jtroyer76/n2k_atom_can485_hw/fab/n2k_atom_can485-bom-jlcpcb.csv

Comment | Designator | Footprint | LCSC Part #
4.7u/50V | C1 | C_1206_3216Metric | C29823
100n/50V | C2,C3,C5,C6,C8,C11 | C_0603_1608Metric | C14663
22u/25V | C4 | C_0805_2012Metric | C45783
10u/25V | C7,C10 | C_0805_2012Metric | C15850
1u/50V | C9,C12 | C_0603_1608Metric | C15849
SMBJ20A | D1 | D_SMB | C19077575
SS14 | D2 | D_SMA | C2480
B5819W | D3 | D_SOD-123 | C8598
PESD2CAN | D4 | SOT-23 | C75176
0.5A/60V PTC | F1 | Fuse_1812_4532Metric | C883142
15u | L1 | L_Sunlord_SWPA5040S | C44888
120k 1% | R1 | R_0603_1608Metric | C25808
22k 1% | R2 | R_0603_1608Metric | C31850
120 1% | R3,R5 | R_0603_1608Metric | C22787
10k 1% | R4 | R_0603_1608Metric | C25804
LMR54406DBVR | U1 | SOT-23-6 | C5219316
TJA1051T/3 | U2 | SOIC-8_3.9x4.9mm_P1.27mm | C38695
CA-IS2092VW | U3 | SOIC-16W_7.5x10.3mm_P1.27mm | C7422559
