jtroyer76/n2k_atom_can485_hw/enclosure/n2k_atom_can485_case-lid.stl

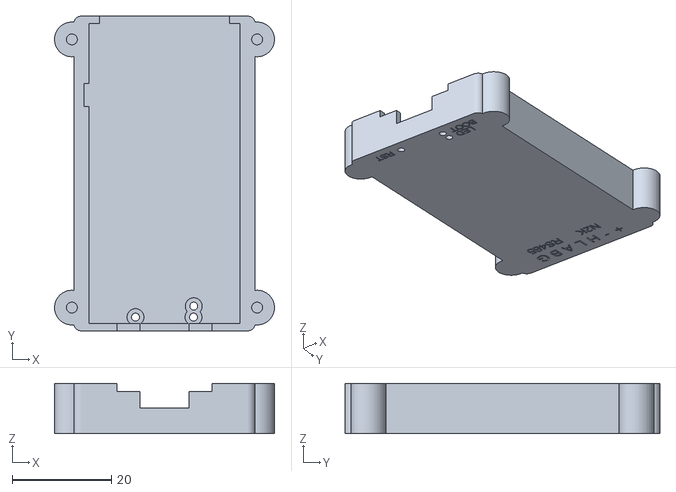
[picture p4: CAD file, 2026-11-02]
enclosure/n2k_atom_can485_case-lid.stl
44.3 x 63.4 x 10.1
