jtroyer76/n2k_atom_can485_hw/enclosure/n2k_atom_can485_case-base.stl

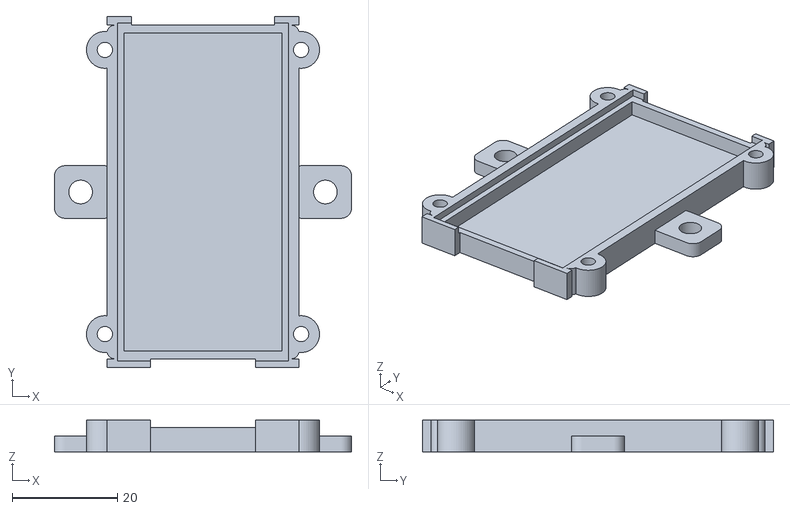
[picture p5: CAD file, 2026-11-02]
enclosure/n2k_atom_can485_case-base.stl
56.5 x 66.7 x 6.00
