jtroyer76/n2k_atom_can485_hw/docs/n2k_atom_can485-schematic.pdf

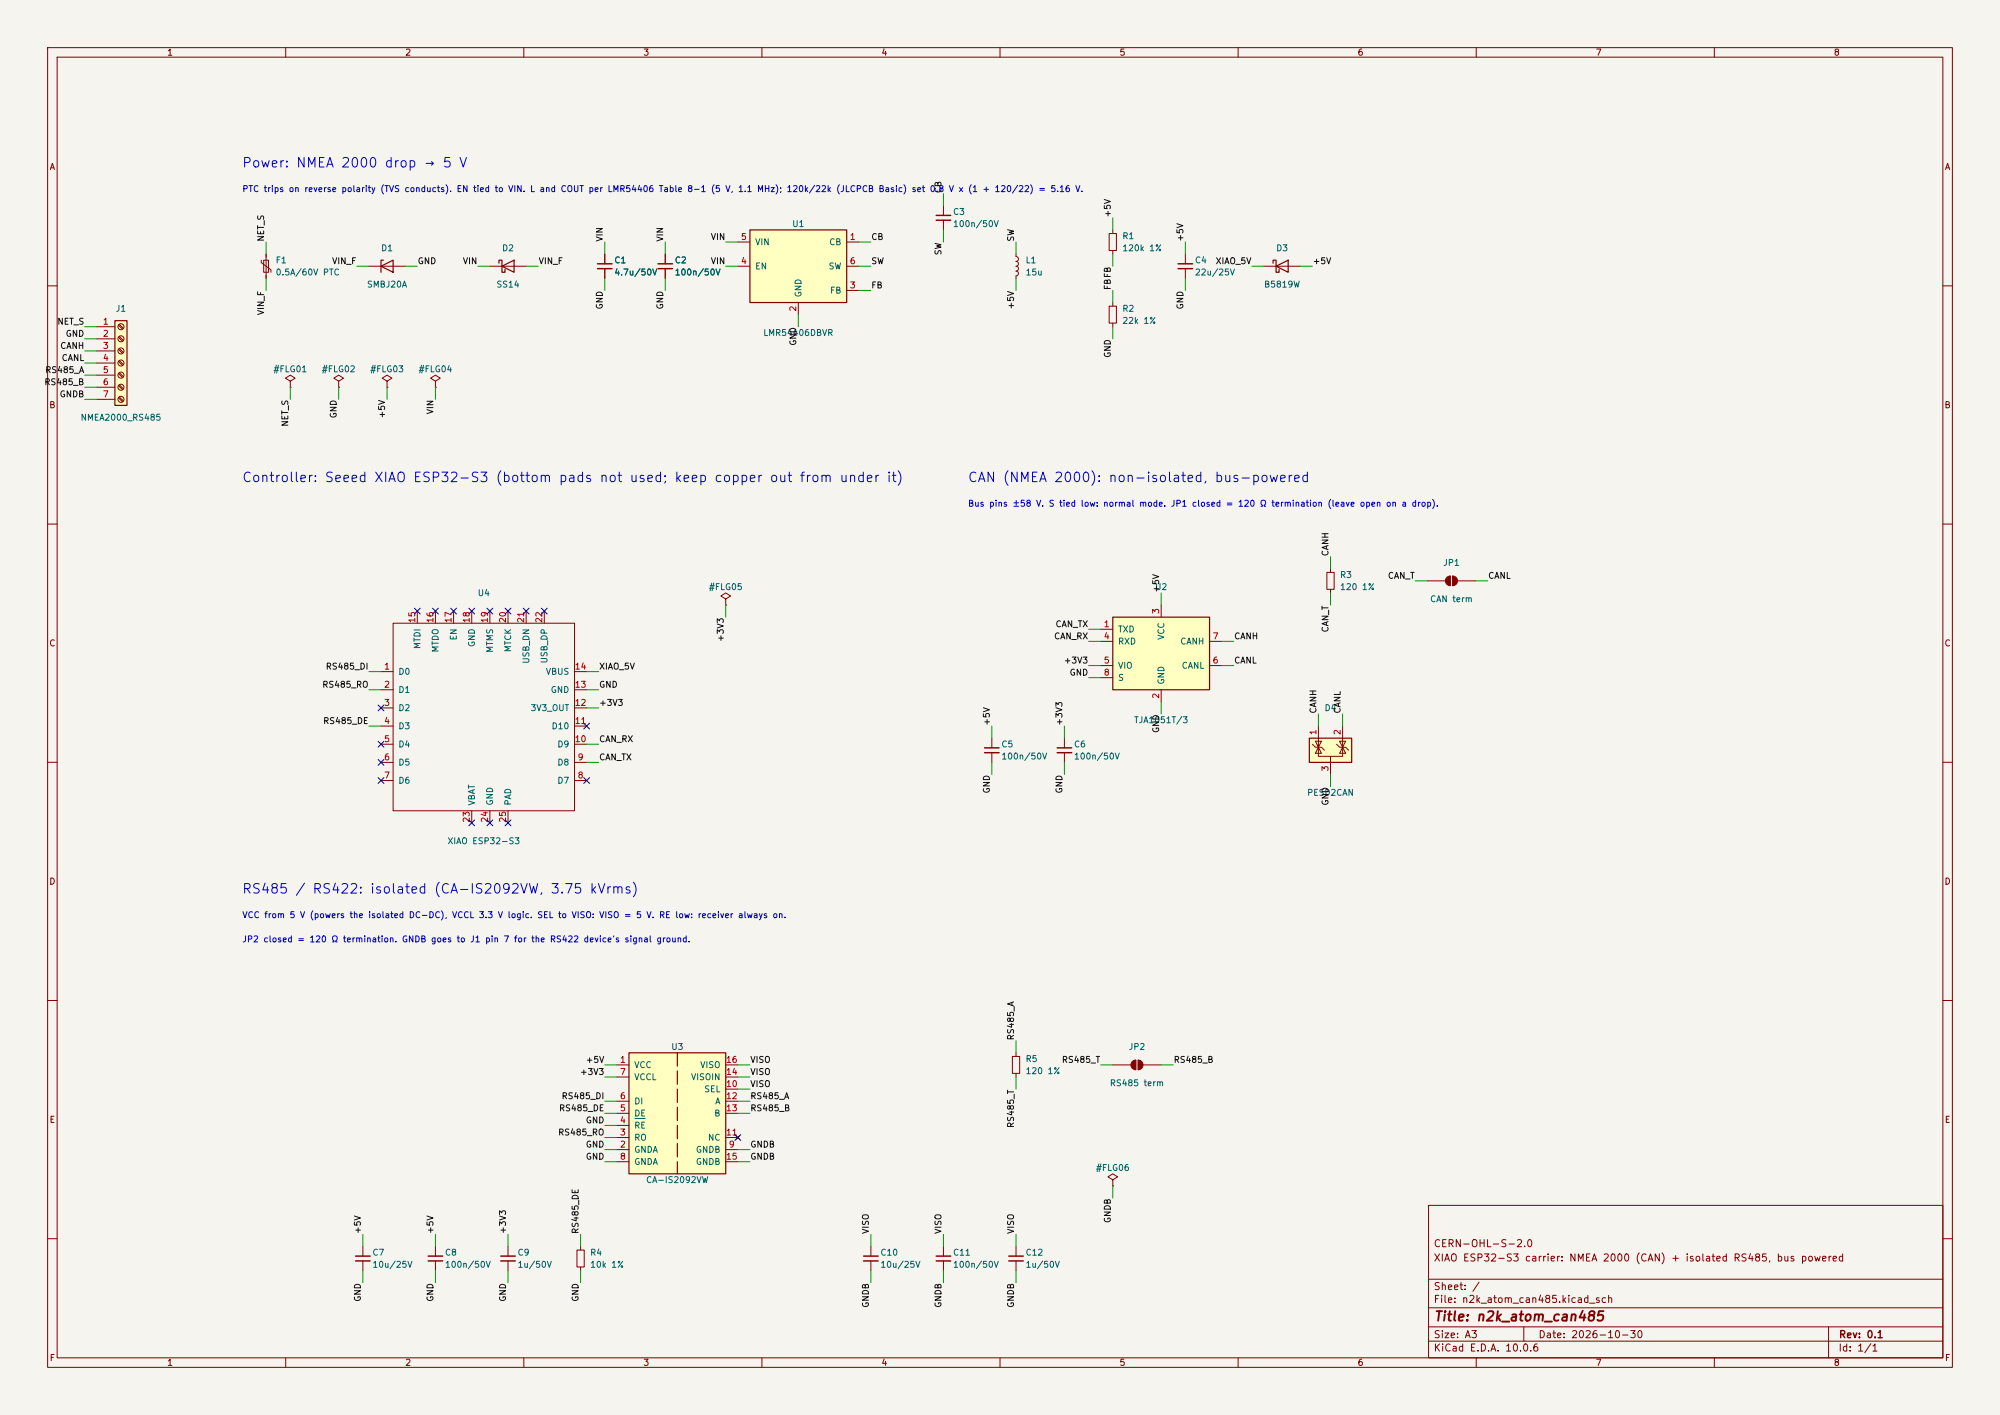
[picture p6: page 1]

Bus pins ±58 V. S tied low: normal mode. JP1 closed = 120 Ω termination (leave open on a drop).

VCC from 5 V (powers the isolated DC-DC), VCCL 3.3 V logic. SEL to VISO: VISO = 5 V. RE low: receiver always on. JP2 closed = 120 Ω termination. GNDB goes to J1 pin 7 for the RS422 device's signal ground.

CERN-OHL-S-2.0
XIAO ESP32-S3 carrier: NMEA 2000 (CAN) + isolated RS485, bus powered

Size: A3 | Rev: 0.1 | F Date: 2026-10-30
KiCad E.D.A. 10.0.6 | Id: 1/1
