jtroyer76/n2k_atom_can485_hw/kicad/n2k_atom_can485.kicad_pcb

## KiCad design kicad/n2k_atom_can485.kicad_pcb (2026-11-02)

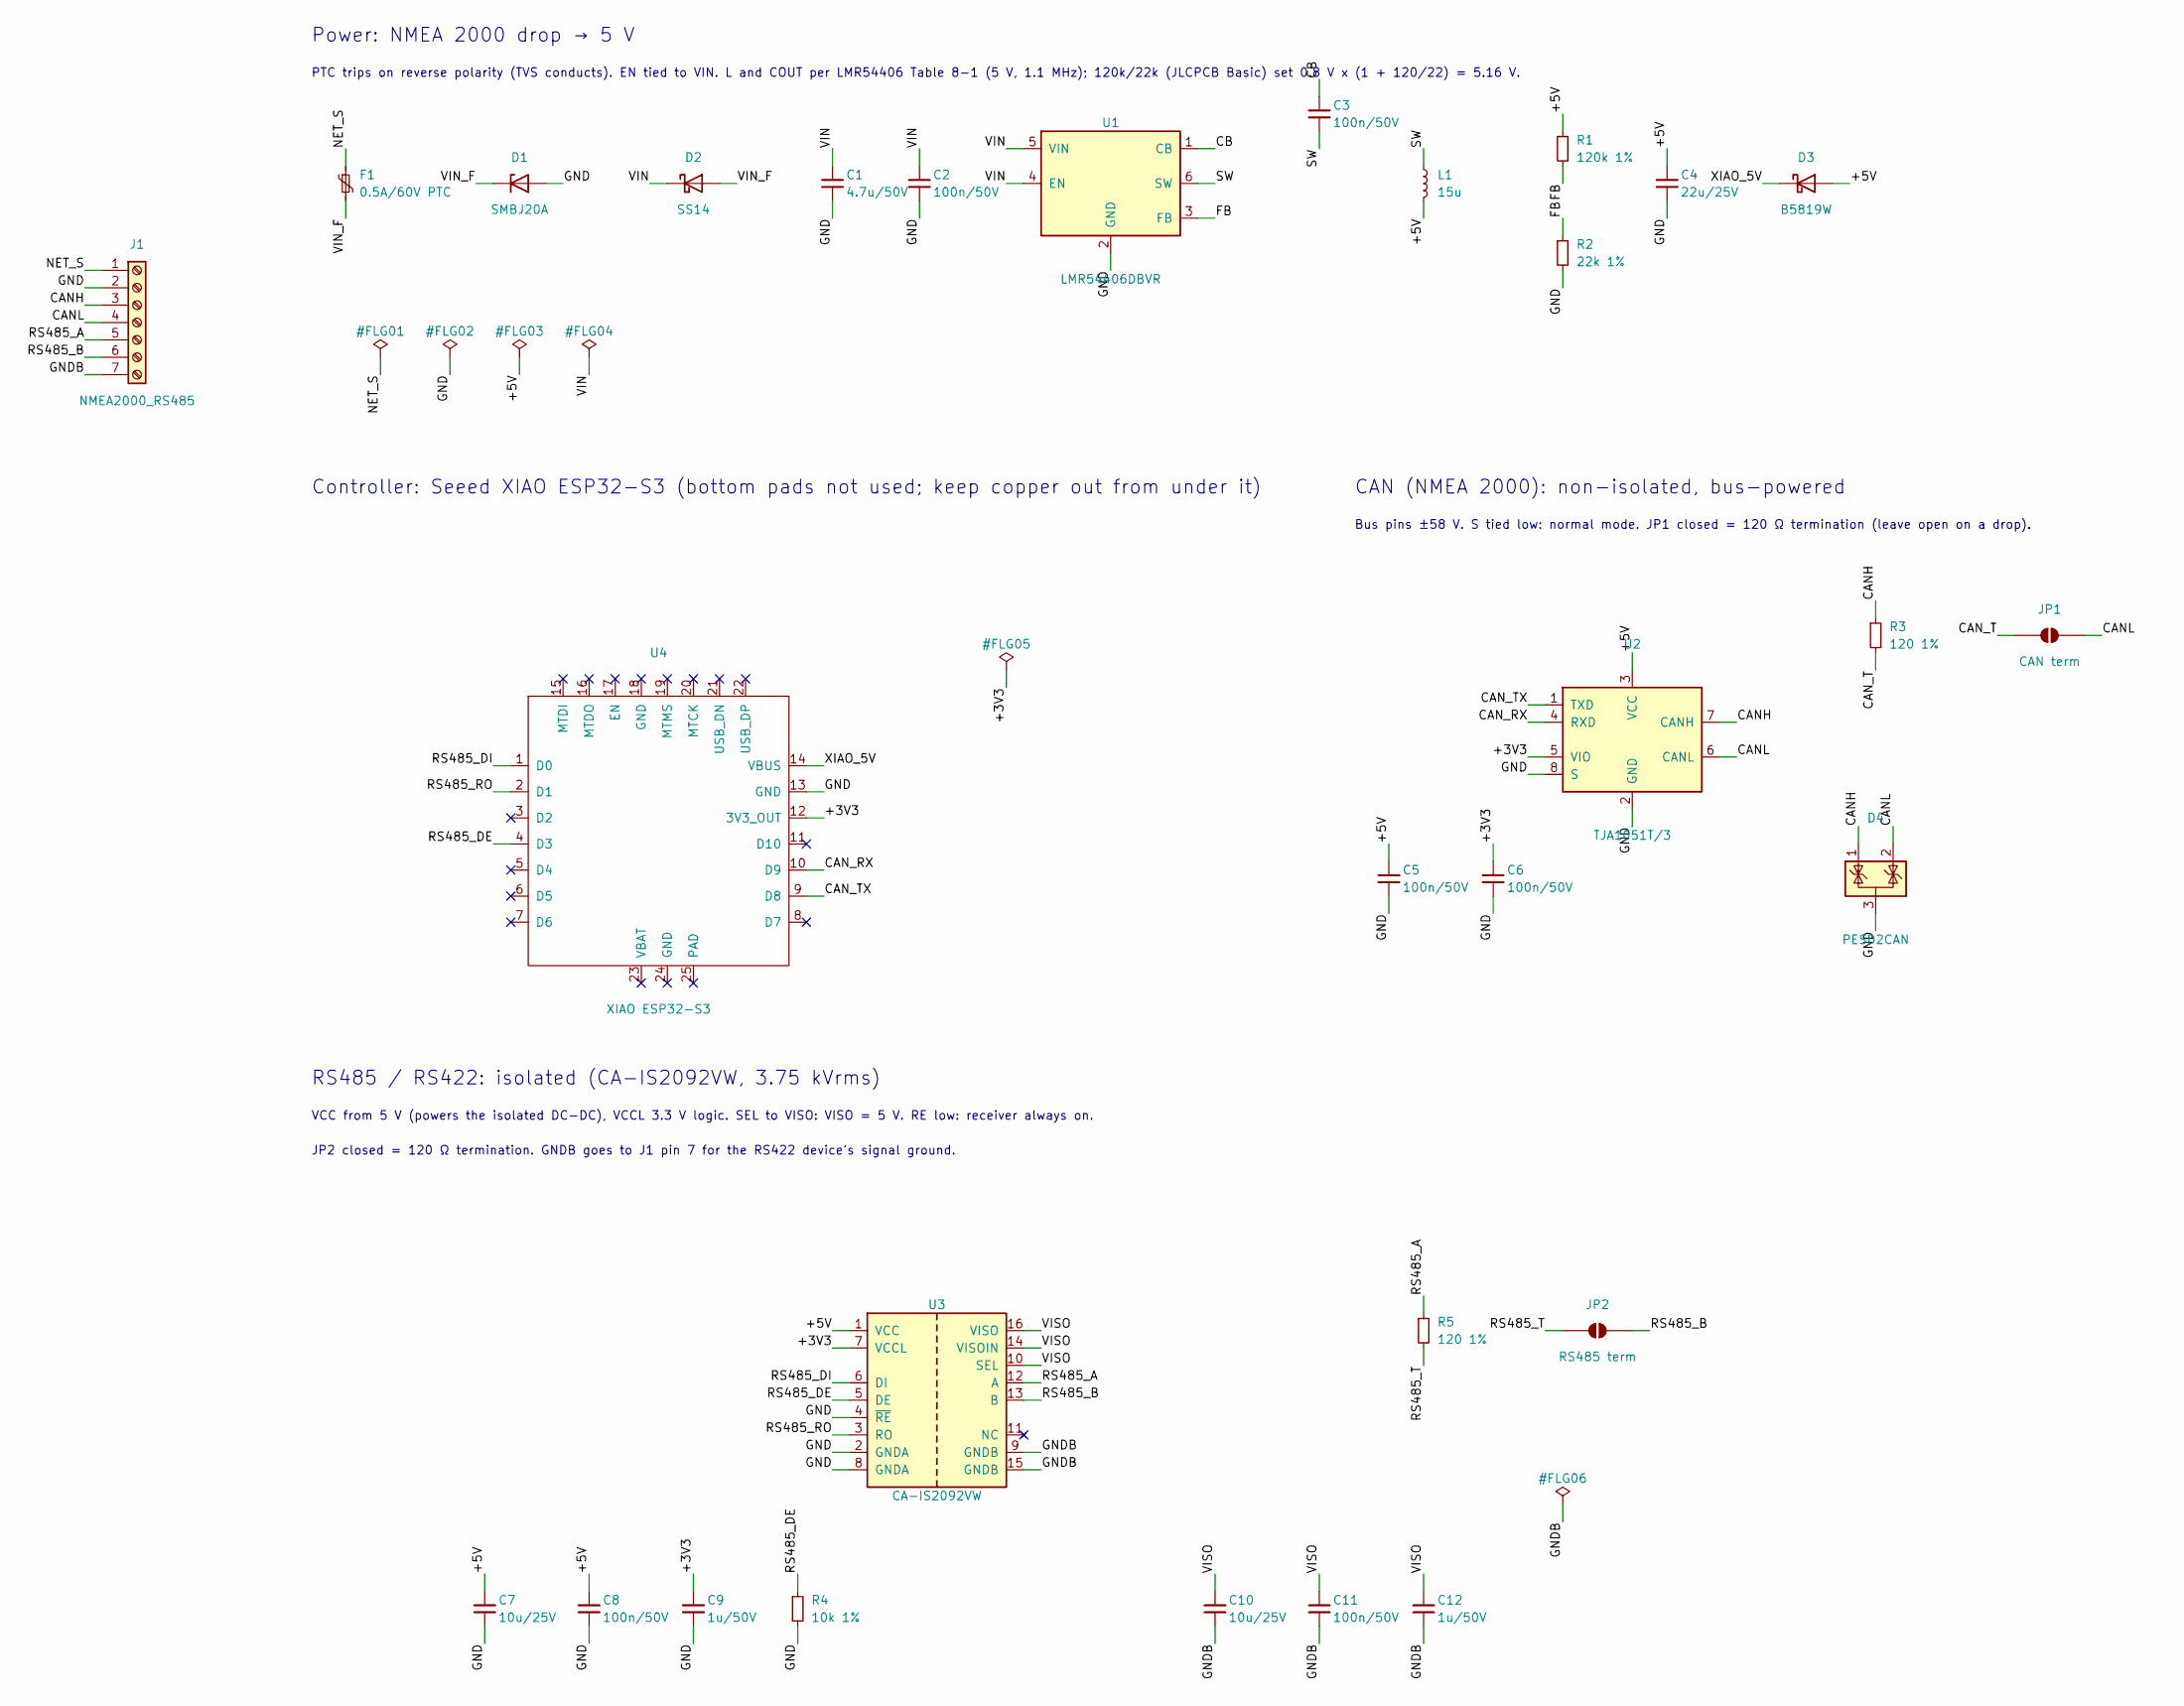
[picture p7: schematic n2k_atom_can485.kicad_sch]

Parts:
C1: 4.7u/50V; C_1206_3216Metric; LCSC C29823
C2, C3, C5, C6, C8, C11: 100n/50V; C_0603_1608Metric; LCSC C14663
C4: 22u/25V; C_0805_2012Metric; LCSC C45783
C7, C10: 10u/25V; C_0805_2012Metric; LCSC C15850
C9, C12: 1u/50V; C_0603_1608Metric; LCSC C15849
D1: SMBJ20A; D_SMB; MPN SMBJ20A (unidirectional TVS); LCSC C19077575
D2: SS14; D_SMA; MPN SS14 (reverse polarity); LCSC C2480
D3: B5819W; D_SOD-123; MPN B5819W; LCSC C8598
D4: PESD2CAN; SOT-23; MPN PESD2CAN,215; LCSC C75176
F1: 0.5A/60V PTC; Fuse_1812_4532Metric; MPN BSMD1812-050-60V; LCSC C883142
J1: NMEA2000_RS485; MX15EDGRC-3.5-07P; MPN MAX MX15EDGRC-3.5-07P-GN01-Cu-A; LCSC C5188300
JP1: CAN term; SolderJumper-2_P1.3mm_Open_RoundedPad1.0x1.5mm
JP2: RS485 term; SolderJumper-2_P1.3mm_Open_RoundedPad1.0x1.5mm
L1: 15u; L_Sunlord_SWPA5040S; MPN SWPA5040S150MT; LCSC C44888
R1: 120k 1%; R_0603_1608Metric; LCSC C25808
R2: 22k 1%; R_0603_1608Metric; LCSC C31850
R3, R5: 120 1%; R_0603_1608Metric; LCSC C22787
R4: 10k 1%; R_0603_1608Metric; LCSC C25804
U1: LMR54406DBVR; SOT-23-6; MPN LMR54406DBVR; LCSC C5219316
U2: TJA1051T/3; SOIC-8_3.9x4.9mm_P1.27mm; MPN TJA1051T/3/1J; LCSC C38695
U3: CA-IS2092VW; SOIC-16W_7.5x10.3mm_P1.27mm; MPN CA-IS2092VW; LCSC C7422559
U4: XIAO ESP32-S3; XIAO-ESP32-S3-SMD-HandSolder; MPN Seeed 113991114; LCSC C20467913

Connections:
/+3V3: C6.1, C9.1, U2.5 (VIO), U3.7 (VCCL), U4.12 (3V3_OUT)
/+5V: C4.1, C5.1, C7.1, C8.1, D3.2 (A), L1.2, R1.1, U2.3 (VCC), U3.1 (VCC)
/CANH: D4.1 (K), J1.3, R3.1, U2.7 (CANH)
/CANL: D4.2 (K), J1.4, JP1.2 (B), U2.6 (CANL)
/CAN_RX: U2.4 (RXD), U4.10 (D9)
/CAN_T: JP1.1 (A), R3.2
/CAN_TX: U2.1 (TXD), U4.9 (D8)
/CB: C3.1, U1.1 (CB)
/FB: R1.2, R2.1, U1.3 (FB)
/GND: C1.2, C2.2, C4.2, C5.2, C6.2, C7.2, C8.2, C9.2, D1.2 (A), D4.3 (A), J1.2, R2.2, R4.2, U1.2 (GND), U2.2 (GND), U2.8 (S), U3.2 (GNDA), U3.4 (~RE), U3.8 (GNDA), U4.13 (GND)
/GNDB: C10.2, C11.2, C12.2, J1.7, U3.9 (GNDB), U3.15 (GNDB)
/NET_S: F1.1, J1.1
/RS485_A: J1.5, R5.1, U3.12 (A)
/RS485_B: J1.6, JP2.2 (B), U3.13 (B)
/RS485_DE: R4.1, U3.5 (DE), U4.4 (D3)
/RS485_DI: U3.6 (DI), U4.1 (D0)
/RS485_RO: U3.3 (RO), U4.2 (D1)
/RS485_T: JP2.1 (A), R5.2
/SW: C3.2, L1.1, U1.6 (SW)
/VIN: C1.1, C2.1, D2.1 (K), U1.4 (EN), U1.5 (VIN)
/VIN_F: D1.1 (K), D2.2 (A), F1.2
/VISO: C10.1, C11.1, C12.1, U3.10 (SEL), U3.14 (VISOIN), U3.16 (VISO)
/XIAO_5V: D3.1 (K), U4.14 (VBUS)

Notes on the sheet:
Power: NMEA 2000 drop → 5 V
PTC trips on reverse polarity (TVS conducts). EN tied to VIN. L and COUT per LMR54406 Table 8-1 (5 V, 1.1 MHz); 120k/22k (JLCPCB Basic) set 0.8 V x (1 + 120/22) = 5.16 V.
Controller: Seeed XIAO ESP32-S3 (bottom pads not used; keep copper out from under it)
CAN (NMEA 2000): non-isolated, bus-powered
Bus pins ±58 V. S tied low: normal mode. JP1 closed = 120 Ω termination (leave open on a drop).
RS485 / RS422: isolated (CA-IS2092VW, 3.75 kVrms)
VCC from 5 V (powers the isolated DC-DC), VCCL 3.3 V logic. SEL to VISO: VISO = 5 V. RE low: receiver always on.
JP2 closed = 120 Ω termination. GNDB goes to J1 pin 7 for the RS422 device's signal ground.

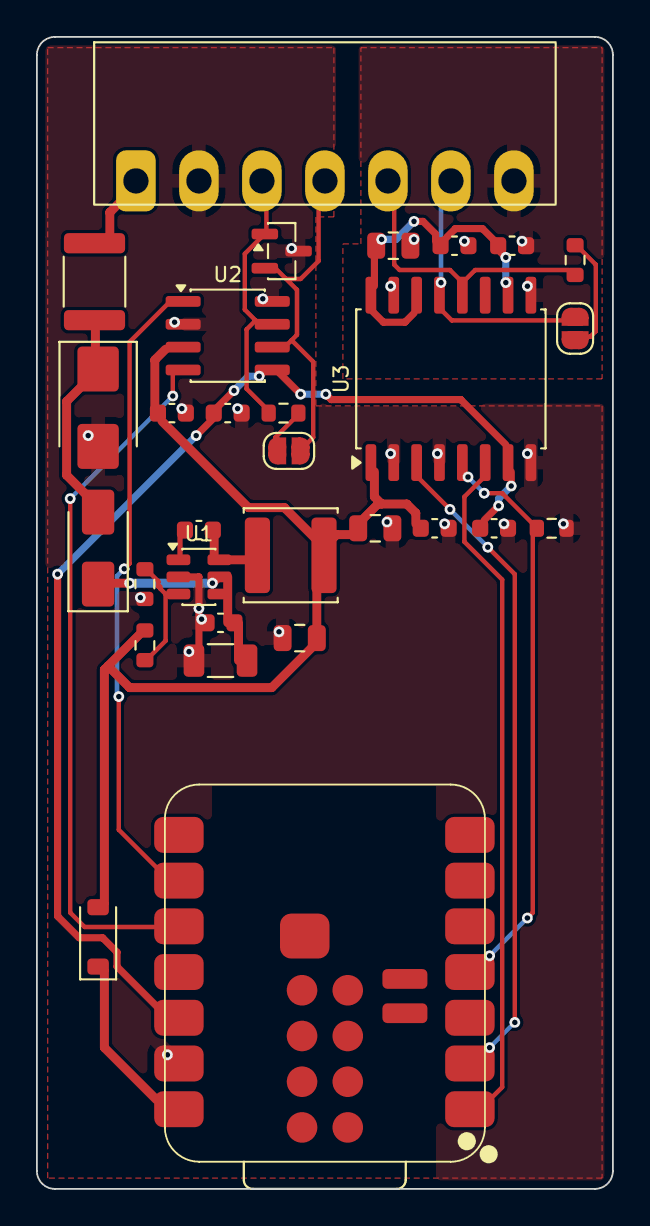
[picture p8: board n2k_atom_can485.kicad_pcb from above]

Board: 2 copper layers, 32.0 x 64.0 mm, 30 parts (0 on the bottom side), 23 nets.
