jtroyer76/n2k_atom_can485_hw/(commit log)

2026-10-31 docs: switch to XIAO ESP32-S3 carrier with own enclosure
2026-10-31 feat: schematic for XIAO ESP32-S3 carrier with CAN and isolated RS485
    [n2k_atom_can485.kicad_sch]
2026-10-31 feat: PCB layout v0.1 with JLCPCB fab files
    32 x 64 mm, 2 layers. CAN moves to D8/D9 and RS485 to D0/D1/D3 so each sits on its side of the board. Feedback divider 120k/22k (JLCPCB Basic, 5.16 V). Terminal footprint drawn from the MX15EDGR drawing. No mounting holes.
    [n2k_atom_can485-B_Cu.gbr, n2k_atom_can485-B_Mask.gbr, n2k_atom_can485-B_Paste.gbr, n2k_atom_can485-B_Silkscreen.gbr, n2k_atom_can485-Edge_Cuts.gbr, n2k_atom_can485-F_Cu.gbr, n2k_atom_can485-F_Mask.gbr, n2k_atom_can485-F_Paste.gbr]
2026-10-31 feat: DRC rule for the RS485 isolation gap
    Adds a 1 mm clearance rule between isolated-side and other copper, and records the Freerouting cross-check of the v0.1 routing in the spec.
2026-10-31 refactor: remove in-pad track stubs
    Removes 138 track segments that lay wholly inside the pad they connect to (110 of them off-angle jogs from the routing grid to the pad centre). No change to connectivity or DRC; Gerbers regenerated.
    [n2k_atom_can485-B_Cu.gbr, n2k_atom_can485-B_Mask.gbr, n2k_atom_can485-B_Paste.gbr, n2k_atom_can485-B_Silkscreen.gbr, n2k_atom_can485-Edge_Cuts.gbr, n2k_atom_can485-F_Cu.gbr, n2k_atom_can485-F_Mask.gbr, n2k_atom_can485-F_Paste.gbr]
2026-11-02 build: hand-solder the terminal and XIAO
    J1 and U4 come out of the JLCPCB BOM and placement files. U4 moves to a copy of Seeed's footprint without paste, so the stencil leaves no solder under the hand-soldered module.
    [n2k_atom_can485-B_Cu.gbr, n2k_atom_can485-B_Mask.gbr, n2k_atom_can485-B_Paste.gbr, n2k_atom_can485-B_Silkscreen.gbr, n2k_atom_can485-Edge_Cuts.gbr, n2k_atom_can485-F_Cu.gbr, n2k_atom_can485-F_Mask.gbr, n2k_atom_can485-F_Paste.gbr]
2026-11-02 docs: buck layout checked against the datasheet
2026-11-02 feat: tighter buck input loop
    C2 moves under U1 with a direct VIN strap and a GND return under the package (datasheet Fig. 8-11); C1 follows. Hides the J1 reference, which landed beside D4. Gerbers, placement file and renders regenerated.
    [n2k_atom_can485-B_Cu.gbr, n2k_atom_can485-B_Mask.gbr, n2k_atom_can485-B_Paste.gbr, n2k_atom_can485-B_Silkscreen.gbr, n2k_atom_can485-Edge_Cuts.gbr, n2k_atom_can485-F_Cu.gbr, n2k_atom_can485-F_Mask.gbr, n2k_atom_can485-F_Paste.gbr]
2026-11-02 docs: no carrier LEDs in v0.1
2026-11-02 fix: JLCPCB rotation corrections in the placement file
    U1 and D4 +180, U2 and U3 -90, from JLCPCB's placement preview.
    [n2k_atom_can485-cpl-jlcpcb.csv]
2026-11-02 feat: 3D-printed enclosure
    OpenSCAD base and lid that clamp the board by its edges: ledges in the base,
    ribs in the lid, corner hooks past the board ends. Openings for the terminal
    and USB-C, holes for the XIAO user LED, BOOT and RESET, engraved pin labels,
    two mounting tabs, four M2.5 screws from below. Rendered STLs included; not
    yet printed or test-fitted.
    [n2k_atom_can485_case-base.stl, n2k_atom_can485_case-lid.stl, n2k_atom_can485_case.scad]
